polizze/controlador-tda1085c-agujereadora/Hardware/BOM_KiCad.csv

Refs | Value | Footprint | Qty | DNP | Parameters_and_Notes
C3 | 100nF | Capacitor_THT:C_Disc_D5.0mm_W2.5mm_P5.00mm | 1 |  | Filtro inmunidad ruido Pin 3 (I_LIM)
C4 | 470nF | Capacitor_THT:C_Rect_L7.2mm_W3.5mm_P5.00mm_FKS2_FKP2_MKS2_MKP2 | 1 |  | Integrador conversor F/V Pin 4 (5.14V @ 2500 RPM)
C5 | 100nF | Capacitor_THT:C_Disc_D5.0mm_W2.5mm_P5.00mm | 1 |  | Filtro consigna velocidad Pin 5 (V_SET)
C7 | 4.7uF / 50V | Capacitor_THT:CP_Radial_D6.3mm_P2.50mm | 1 |  | Rampa de aceleracion Soft-Start Pin 7
C11 | 1nF (o 470pF) | Capacitor_THT:C_Rect_L7.2mm_W3.5mm_P5.00mm_FKS2_FKP2_MKS2_MKP2 | 1 |  | Bomba de carga F/V Pin 11 (f_max = 166.6 Hz @ 2500 RPM)
C12 | 10nF (Prot. Picos) | Capacitor_THT:C_Disc_D5.0mm_W2.5mm_P5.00mm | 1 |  | Proteccion picos inductivos entrada Tacometro Pin 12 (f_c = 1.59 kHz)
C14 | 47nF (100Hz Saw) | Capacitor_THT:C_Rect_L7.2mm_W3.5mm_P5.00mm_FKS2_FKP2_MKS2_MKP2 | 1 |  | Generador rampa diente de sierra 100 Hz Pin 14
C16 | 1uF / 50V | Capacitor_THT:CP_Radial_D6.3mm_P2.50mm | 1 |  | Compensacion integral lazo PI Pin 16 (f_z = 3.39 Hz)
C17 | 47nF | Capacitor_THT:C_Disc_D5.0mm_W2.5mm_P5.00mm | 1 |  | Polo alta frecuencia lazo PI Pin 16 (f_p = 72.0 Hz)
C_DEC1 | 100nF | Capacitor_THT:C_Disc_D5.0mm_W2.5mm_P5.00mm | 1 |  | Desacoplo ceramico +VCC junto a Pines 8-9-10
C_SNUB1 | 100nF 400V X2 | Capacitor_THT:C_Rect_L18.0mm_W6.0mm_P15.00mm_FKS3_FKP3 | 1 |  | Polipropileno Clase X2 Red Snubber MT1-MT2
C_VCC1 | 220uF / 25V | Capacitor_THT:CP_Radial_D10.0mm_P5.00mm | 1 |  | Filtro principal +VCC (15.24V) para soportar picos de Gate de 88mA (admite 470uF/25V)
D1 | 1N4007 | Diode_THT:D_DO-41_SOD81_P10.16mm_Horizontal | 1 |  | Rectificador media onda fuente sin transformador
J1 | AC_220V_&_MOTOR_OUT | TerminalBlock_Phoenix:TerminalBlock_Phoenix_MKDS-3-4-5.08_1x04_P5.08mm_Horizontal | 1 |  | 1:L1_MT1 | 2:MT2->Motor Pin 6 (Azul Rotor) | 3:L2->Motor Pin 5 (Negro Estator) | 4:L2_AC_HOT
J2 | POT_PANEL_10k | Connector_PinHeader_2.54mm:PinHeader_1x03_P2.54mm_Vertical | 1 |  | Conector potenciometro lineal 10k de panel (400 - 2500 RPM)
J3 | TACHO_P3_P4 (73.0R 8P) | TerminalBlock_Phoenix:TerminalBlock_Phoenix_MKDS-1,5-2-5.08_1x02_P5.08mm_Horizontal | 1 |  | Entrada Tacometro Motor Pines 3 y 4 Rojos (R_tacho = 73.0 Ohm, 8 polos, 166.6 Hz @ 2500 RPM)
Q1 | BTB12-600BW (NO AISLADO) | TDA1085C_Custom:BTB12-600BW_Heatsink_40x20x80mm_LIVE_TAB | 1 |  | Triac Snubberless I_GT=50mA con Disipador 40x20x80mm - PELIGRO: ALETA VIVA EN MT2 (AISLAR CHASIS)
R1 | 820k 1/2W | Resistor_THT:R_Axial_DIN0411_L9.9mm_D3.6mm_P12.70mm_Horizontal | 1 |  | Sincronismo de corriente Triac (MT2 a Pin 1)
R2 | 820k 1/2W | Resistor_THT:R_Axial_DIN0411_L9.9mm_D3.6mm_P12.70mm_Horizontal | 1 |  | Sincronismo de tension AC (L2_AC_HOT a Pin 2)
R3 | 10k | Resistor_THT:R_Axial_DIN0207_L6.3mm_D2.5mm_P10.16mm_Horizontal | 1 |  | Referencia Pin 3 (I_LIM) a GND_CHIP
R4 | 270k | Resistor_THT:R_Axial_DIN0207_L6.3mm_D2.5mm_P10.16mm_Horizontal | 1 |  | Resistencia ganancia conversor F/V Pin 4 (270k con C11=1nF / 330k con C11=470pF)
R11 | 470k | Resistor_THT:R_Axial_DIN0207_L6.3mm_D2.5mm_P10.16mm_Horizontal | 1 |  | Polarizacion bomba de carga Pin 11 hacia +VCC (Pin 9)
R12 | 10k | Resistor_THT:R_Axial_DIN0207_L6.3mm_D2.5mm_P10.16mm_Horizontal | 1 |  | Limitadora de corriente entrada Tacometro Pin 12 (I_pk = 0.84 mA)
R15 | 270k | Resistor_THT:R_Axial_DIN0207_L6.3mm_D2.5mm_P10.16mm_Horizontal | 1 |  | Programacion corriente de rampa Pin 15 hacia +VCC (Pin 9)
R16 | 47k | Resistor_THT:R_Axial_DIN0207_L6.3mm_D2.5mm_P10.16mm_Horizontal | 1 |  | Ganancia proporcional lazo PI Pin 16 (Kp = 16 V/V)
RV1 | 50k Multivuelta | Potentiometer_THT:Potentiometer_Bourns_3296W_Vertical | 1 |  | Preset Bourns 3296W en serie con J2 para calibrar tope de 2500 RPM (ajuste ~24.1k)
R_DROP1 | 4.7k 3W (Elevar 5mm) | TDA1085C_Custom:R_Axial_3W_Elevated_Pad2.5mm_Drill1.2mm | 1 |  | Caida de tension etapa 1 (MOX 3W, Pad 2.5mm / Agujero 1.2mm, montar a 5mm del PCB)
R_DROP2 | 4.7k 3W (Elevar 5mm) | TDA1085C_Custom:R_Axial_3W_Elevated_Pad2.5mm_Drill1.2mm | 1 |  | Caida de tension etapa 2 (MOX 3W, Pad 2.5mm / Agujero 1.2mm, montar a 5mm del PCB)
R_GATE1 | 150R 1W | Resistor_THT:R_Axial_DIN0411_L9.9mm_D3.6mm_P12.70mm_Horizontal | 1 |  | Resistencia disparo Gate Pin 13 a Gate (I_G_pk = 88mA > 50mA I_GT)
R_MIN1 | 2.2k (Piso 400 RPM) | Resistor_THT:R_Axial_DIN0207_L6.3mm_D2.5mm_P10.16mm_Horizontal | 1 |  | Fija piso de 400 RPM (0.92V en Pin 5) al 0% del potenciometro
R_SNUB1 | 100R 1W | Resistor_THT:R_Axial_DIN0411_L9.9mm_D3.6mm_P12.70mm_Horizontal | 1 |  | Resistencia Red Snubber RC en serie con C_SNUB1
U1 | TDA1085C | Package_DIP:DIP-16_W7.62mm_Socket_LongPads | 1 |  | Controlador Universal Lazo Cerrado PI (Pin 8 GND_CHIP en Star Ground unico desde MT1)
M1 | Motor Universal C.E.SET. MCA 52/64-148/ALL7 | Externo_Bornera_7_Pines | 1 |  | R_estator(P1-P5)=2.1R + R_rotor(P2-P6)=6.5R -> R_tot=8.6R, L=25-30mH | Puente Serie P1(Gris osc)-P2(Violeta) | Tacho(P3-P4)=73.0R 8 Polos
FL1 | Filtro EMI FLCR47050 (250V 16A) | Externo_Chasis | 1 |  | Filtro EMI de linea previo a J1 + Fusible 4A
