polizze/controlador-tda1085c-agujereadora/Hardware/Fabrication/Esquematico_TDA1085C.pdf

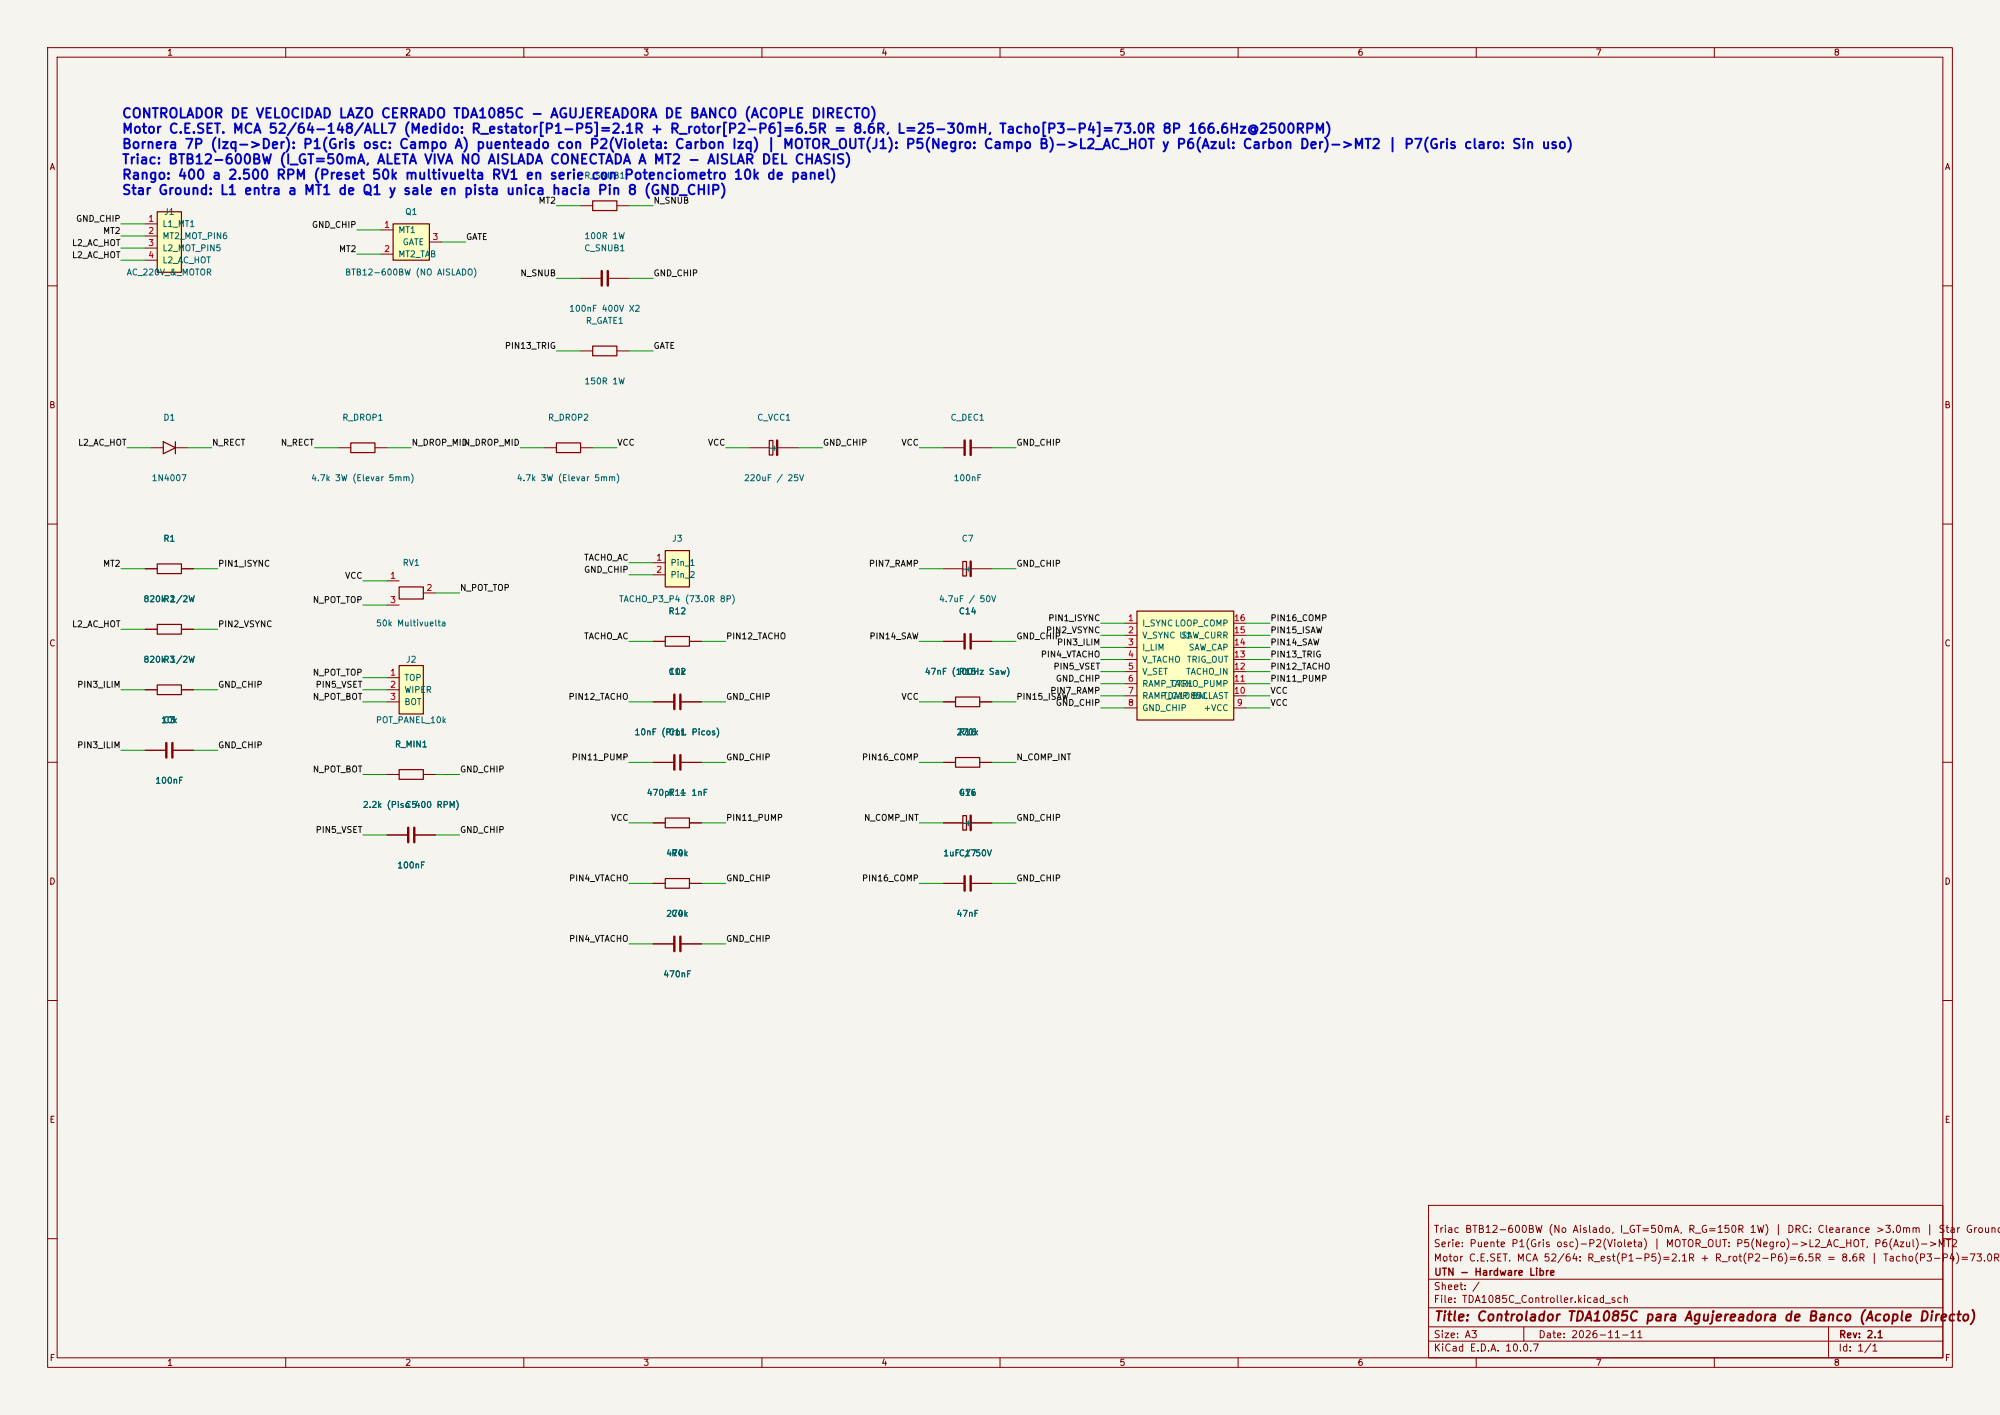
[picture p5: page 1]

GND_CHIP CONTROLADOR DE VELOCIDAD LAZO CERRADO TDA1085C - AGUJEREADORA DE BANCO (ACOPLE DIRECTO)
Motor C.E.SET. MCA 52/64-148/ALL7 (Medido: R_estator[P1-P5]=2.1R + R_rotor[P2-P6]=6.5R = 8.6R, L=25-30mH, Tacho[P3-P4]=73.0R 8P 166.6Hz@2500RPM)
Bornera 7P (Izq->Der): P1(Gris osc: Campo A) puenteado con P2(Violeta: Carbon Izq) | MOTOR_OUT(J1): P5(Negro: Campo B)->L2_AC_HOT y P6(Azul: Carbon Der)->MT2 | P7(Gris claro: Sin uso)
Triac: BTB12-600BW (I_GT=50mA, ALETA VIVA NO AISLADA CONECTADA A MT2 - AISLAR DEL CHASIS)
Rango: 400 a 2.500 RPM (Preset 50k multivuelta RV1 en serie con Potenciometro 10k de panel)
Star Ground: L1 entra a MT1 de Q1 y sale en pista unica hacia Pin 8 (GND_CHIP)

Triac BTB12-600BW (No Aislado, I_GT=50mA, R_G=150R 1W) | DRC: Clearance >3.0mm | Star Ground MT1
Serie: Puente P1(Gris osc)-P2(Violeta) | MOTOR_OUT: P5(Negro)->L2_AC_HOT, P6(Azul)->MT2
Motor C.E.SET. MCA 52/64: R_est(P1-P5)=2.1R + R_rot(P2-P6)=6.5R = 8.6R | Tacho(P3-P4)=73.0R 8P
UTN - Hardware Libre
Sheet: /
File: TDA1085C_Controller.kicad_sch
Title: Controlador TDA1085C para Agujereadora de Banco (Acople Directo)

Size: A3 | Rev: 2.1 | F Date: 2026-11-11
KiCad E.D.A. 10.0.7 | Id: 1/1
