polizze/controlador-tda1085c-agujereadora/Hardware/Fabrication/PCB_TDA1085C_Preview.pdf

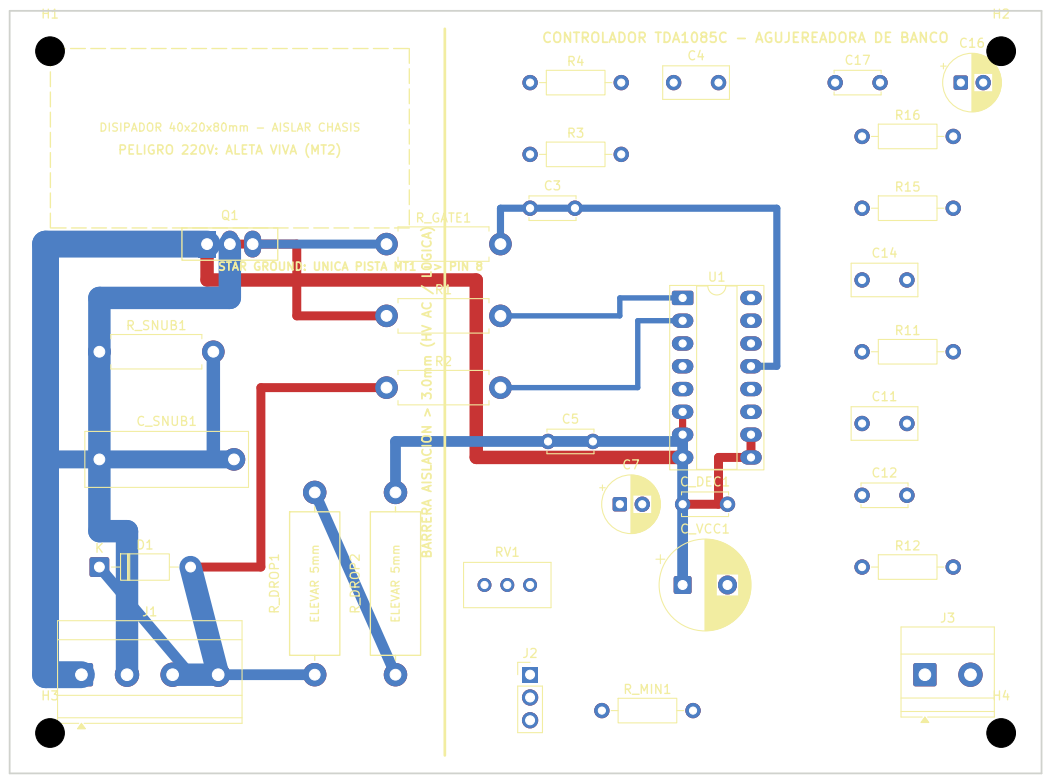
[picture p6: page 1]
