polizze/controlador-tda1085c-agujereadora/Simulations/etapa1b_conversor_fv_tacho.asc

B_MIRROR4_400: bi; I=if(V(PIN12_400)>0.1, 10.2*(13.9-V(PIN11_400))/10k, 0)
B_MIRROR4_2500: bi; I=if(V(PIN12_2500)>0.1, 10.2*(13.9-V(PIN11_2500))/10k, 0)
B_MIRROR4_ORIG: bi; I=if(V(PIN12_2500)>0.1, 10.2*(13.9-V(PIN11_2500))/10k, 0)
B_PUMP11_400: bi; I=if(V(PIN12_400)>0.1, (13.9-V(PIN11_400))/10k, (3.11-V(PIN11_400))/95.6k)
B_PUMP11_2500: bi; I=if(V(PIN12_2500)>0.1, (13.9-V(PIN11_2500))/10k, (3.11-V(PIN11_2500))/95.6k)
C4_OPT_400: cap; 470n
C4_OPT_2500: cap; 470n
C4_ORIG: cap; 470n
C11_400: cap; 1n
C11_2500: cap; 1n
C12_400: cap; 10n
C12_2500: cap; 10n
D_CLAMP12_1: diode; DCLAMP
D_CLAMP12_2: diode; DCLAMP
R4_OPT_400: res; 330k
R4_OPT_2500: res; 330k
R4_ORIG_68K: res; 68k
R12_400: res; 10k
R12_2500: res; 10k
R_BOB1: res; 73.0
R_BOB2: res; 73.0
R_DC11_1: res; 100Meg
R_DC11_2: res; 100Meg
V_TACHO_400RPM: voltage; SINE(0 1.414 26.67)
V_TACHO_2500RPM: voltage; SINE(0 8.84 166.6)
Named nets: 0, V_TACHO_RAW_2500, N_TC_2500, PIN12_2500, V_TACHO_RAW_400, N_TC_400, PIN12_400, PIN11_2500, PIN4_2500_OPT, PIN11_400, PIN4_400_OPT, PIN4_2500_68K_ORIG
.tran 0 1.2 0.8 20u
.model DCLAMP D(Is=10n Rs=2 N=1.2)
.meas TRAN Vpin12_2500_max MAX V(PIN12_2500)
.meas TRAN Vpin12_400_max MAX V(PIN12_400)
.meas TRAN Vpin11_2500_max MAX V(PIN11_2500)
.meas TRAN Vpin11_2500_min MIN V(PIN11_2500)
.meas TRAN Vpin4_2500_opt_avg AVG V(PIN4_2500_OPT)
.meas TRAN Vpin4_2500_opt_pp PP V(PIN4_2500_OPT)
.meas TRAN Vpin4_400_opt_avg AVG V(PIN4_400_OPT)
.meas TRAN Vpin4_400_opt_pp PP V(PIN4_400_OPT)
.meas TRAN Vpin4_2500_orig68k_avg AVG V(PIN4_2500_68K_ORIG)
RAMA 1: TACO A 2500 RPM (8 Polos -> f = 166.67 Hz, Vtacho = 8.84 Vpk) CON ESCALADO OPTIMIZADO (C11=1nF, R4=330k)
RAMA 2: TACO A 400 RPM (8 Polos -> f = 26.67 Hz, Vtacho = 1.41 Vpk) CON ESCALADO OPTIMIZADO (C11=1nF, R4=330k)
RAMA 3 (COMPARACION): SALIDA PIN 4 A 2500 RPM CON R4=68k ORIGINAL (Da solo ~1.25V en vez de 6V!)
