polizze/controlador-tda1085c-agujereadora/Simulations/etapa1c_triac_snubber_motor.asc

B_DVDT: bv; V=ddt(V(MT2))*1u
B_FEM_MOTOR: bv; V=38*tanh(I(L_MOTOR)/0.4)
B_SAW14: bi; I=if(abs(V(L2_AC_HOT))<25, (12.3-V(PIN14_SAW))/50, if(V(PIN14_SAW)>0.2, -55u, 0))
B_SW_NEG: bi; I=((0.5+0.5*tanh((V(GATE_LAT_N)-0.5)*30))/0.03 + 1u)*(V(MT2)-V(N_SCR_N))
B_SW_POS: bi; I=((0.5+0.5*tanh((V(GATE_LAT_P)-0.5)*30))/0.03 + 1u)*(V(MT2)-V(N_SCR_P))
C14_SAW: cap; 47n
C_EMI_X2: cap; 470n
C_SNUB: cap; 100n
D_SCR_NEG: diode; DSCR
D_SCR_POS: diode; DSCR
L_EMI: ind; 1m Rser=0.08
L_MOTOR: ind; 28m
R_DC14: res; 100Meg
R_DUMMY_DVDT: res; 1k
R_GATE: res; 150
R_GK_TRIAC: res; 18
R_MOTOR: res; 8.6
R_SNUB: res; 100
V_AC_220V: voltage; SINE(0 311.13 50)
V_PIN13_PULSE: voltage; PULSE(0 13.8 7.33m 1u 1u 80u 10m)
Named nets: 0, MAINS_RAW, L2_AC_HOT, N_RL_MOTOR, N_FEM_MOTOR, MT2, N_SCR_P, N_SCR_N, N_SNUB, PIN13_TRIG, GATE_NODE, PIN14_SAW, DVDT_SENSE
.tran 0 0.12 0.04 1u
.model DSCR D(Is=10n Rs=0.025 N=1.5 Cjo=150p TT=2u)
V_LAT_P GATE_LAT_P 0 PULSE(0 1 7.33m 10u 10u 6.0m 20m)
V_LAT_N GATE_LAT_N 0 PULSE(0 1 17.33m 10u 10u 6.0m 20m)
.meas TRAN I_motor_rms RMS I(L_MOTOR)
.meas TRAN I_motor_pk MAX I(L_MOTOR)
.meas TRAN V_motor_rms RMS (V(L2_AC_HOT)-V(MT2))
.meas TRAN V_mt2_rms RMS V(MT2)
.meas TRAN P_motor_avg AVG (V(L2_AC_HOT)-V(MT2))*I(L_MOTOR)
.meas TRAN P_Triac_avg AVG V(MT2)*(I(B_SW_POS)+I(B_SW_NEG))
.meas TRAN P_Rsnub_avg AVG (V(MT2)-V(N_SNUB))*I(R_SNUB)
.meas TRAN I_snub_pk MAX abs(I(R_SNUB))
.meas TRAN dVdt_comm_off_V_us MAX abs(V(DVDT_SENSE)) FROM 0.050 TO 0.0525
.meas TRAN V_snub_peak_off MAX abs(V(MT2)) FROM 0.050 TO 0.0525
.meas TRAN t_extinction WHEN I(L_MOTOR)=0 FALL=1 TD=0.048
.meas TRAN I_gate_pk MAX -I(R_GATE)
.meas TRAN P_Rgate_avg AVG (V(PIN13_TRIG)-V(GATE_NODE))*-I(R_GATE)
.meas TRAN Vsaw14_max MAX V(PIN14_SAW)
.meas TRAN Vsaw14_min MIN V(PIN14_SAW)
ETAPA 1C: RED 220V 50Hz + FILTRO EMI (FLCR47050) + MOTOR UNIVERSAL SERIE (R=5.2R, L=22mH + FEM) + TRIAC BTA16-600BW + SNUBBER (100R + 100nF)
