polizze/controlador-tda1085c-agujereadora/Simulations/etapa2_lazo_pi_conversor_fv.asc

B_GM_PI_PIN16: bi; I=limit(340u*(V(PIN5_VSET) - V(V_RPM_CLOSED_LOOP)*5.142/2.5), -200u, 200u)
B_MIRROR_PIN4: bi; I=if(V(PIN12_TACHO)>0.1, 10.2*(13.9-V(PIN11_PUMP))/10k, 0)
B_PLANT_TORQUE: bi; I=0.85*limit(V(PIN16_COMP), 0, 12) - I(I_DRILL_LOAD)
B_PUMP_PIN11: bi; I=if(V(PIN12_TACHO)>0.1, (13.9-V(PIN11_PUMP))/10k, (3.11-V(PIN11_PUMP))/95.6k)
C4: cap; 470n
C5: cap; 100n
C11: cap; 1n
C12_PROT: cap; 10n
C16_KI: cap; 1u
C17_HF: cap; 47n
C_INERTIA_MECH: cap; 60m
D_CLAMP12: diode; DCLAMP
R4: res; 270k
R12: res; 10k
R16_KP: res; 47k
R_CLAMP16: res; 10Meg
R_DAMP_MECH: res; 1
R_LEAK11: res; 100Meg
R_MIN_400RPM: res; 2.2k
R_TACHO_MEDIDA: res; 73.0
RV1_PRESET_50K: res; 24.1k
RV_PANEL_10K: res; 10k
V_TACHO_8POLOS: voltage; SINE(0 8.84 166.6)
V_VCC_PIN9: voltage; 15.24
Named nets: 0, TACHO_COIL_RAW, TACHO_P3_P4, PIN12_TACHO, PIN11_PUMP, PIN4_VTACHO, VCC_15V24, PIN5_VSET, N_POT_BOT, PIN16_COMP, N_PI_INT, V_RPM_CLOSED_LOOP
.tran 0 1.4 0.2 50u
.model DCLAMP D(Is=10n Rs=2 N=1.2)
.ic V(PIN16_COMP)=2.94 V(N_PI_INT)=2.94 V(V_RPM_CLOSED_LOOP)=2.50
I_DRILL_LOAD V_RPM_CLOSED_LOOP 0 PULSE(0 0.65 0.60 5m 5m 0.50 2.0)
.meas TRAN Vpin12_pk MAX V(PIN12_TACHO) FROM 0.8 TO 1.2
.meas TRAN I_tacho_pk_mA MAX I(R12)*1000 FROM 0.8 TO 1.2
.meas TRAN Vpin4_2500rpm_avg AVG V(PIN4_VTACHO) FROM 0.8 TO 1.2
.meas TRAN Vpin4_2500rpm_pp PP V(PIN4_VTACHO) FROM 0.8 TO 1.2
.meas TRAN Vpin5_set_max AVG V(PIN5_VSET) FROM 0.8 TO 1.2
.meas TRAN Vpin5_set_min AVG V(N_POT_BOT) FROM 0.8 TO 1.2
.meas TRAN Vpin16_no_load AVG V(PIN16_COMP) FROM 0.45 TO 0.58
.meas TRAN Vpin16_under_load AVG V(PIN16_COMP) FROM 0.90 TO 1.08
.meas TRAN RPM_steady_before AVG V(V_RPM_CLOSED_LOOP)*1000 FROM 0.45 TO 0.58
.meas TRAN RPM_dip_min MIN V(V_RPM_CLOSED_LOOP)*1000 FROM 0.60 TO 0.80
.meas TRAN RPM_steady_recovered AVG V(V_RPM_CLOSED_LOOP)*1000 FROM 0.95 TO 1.08
BLOQUE A: CONVERSOR F-V (Pin 12, 11 y 4) CON PARAMETROS MEDIDOS: R_tacho = 73.0 Ohm, 8 Polos, f(2500 RPM) = 166.6 Hz, C12 = 10nF, C11 = 1nF, R4 = 270k
BLOQUE B: CONSIGNA (Pin 5: Preset 50k + Pot 10k + Piso 2.2k) Y LAZO CERRADO PI (Pin 16: gm=340uA/V, R16=47k + C16=1uF || C17=47nF) ANTE ESCALON DE CARGA EN t=0.6s
