polizze/controlador-tda1085c-agujereadora/Simulations/tda1085c_controlador_completo_btb12.asc

B_BTB12_NEG: bi; I=((0.5+0.5*tanh((V(GATE_LAT_N)-0.5)*30))/0.03 + 1u)*(V(PIN6_ROTOR_AZUL_MT2)-V(N_SCR_N))
B_BTB12_POS: bi; I=((0.5+0.5*tanh((V(GATE_LAT_P)-0.5)*30))/0.03 + 1u)*(V(PIN6_ROTOR_AZUL_MT2)-V(N_SCR_P))
B_FEM_ROTOR: bv; V=38*tanh(I(L_ROTOR_P2_P6)/0.4)
B_MIRROR4_1N: bi; I=if(V(PIN12_TACHO)>0.1, 10.2*(13.9-V(PIN11_1N))/10k, 0)
B_MIRROR4_470P: bi; I=if(V(PIN12_TACHO)>0.1, 10.2*(13.9-V(PIN11_470P))/10k, 0)
B_PUMP_1N: bi; I=if(V(PIN12_TACHO)>0.1, (13.9-V(PIN11_1N))/10k, (3.11-V(PIN11_1N))/95.6k)
B_PUMP_470P: bi; I=if(V(PIN12_TACHO)>0.1, (13.9-V(PIN11_470P))/10k, (3.11-V(PIN11_470P))/95.6k)
C4_A: cap; 470n
C4_B: cap; 470n
C11_A_470P: cap; 470p
C11_B_1N: cap; 1n
C_DEC_VCC: cap; 100n
C_EMI_X2: cap; 470n
C_SNUB_100N_X2: cap; 100n
C_TACHO_PROT_10N: cap; 10n
C_VCC: cap; 220u
D1: diode; D1N4007
D_BTB12_NEG: diode; DSCR
D_BTB12_POS: diode; DSCR
D_GK_BTB12: diode; D1N4007
D_PIN12_CLAMP: diode; DCLAMP
DZ_SHUNT_PIN10: zener; DZ15V6
L_EMI: ind; 1m Rser=0.08
L_ESTATOR_P5_P1: ind; 15m
L_ROTOR_P2_P6: ind; 13m
R4_A: res; 330k
R4_B: res; 270k
R12_LIMIT: res; 10k
R_DC11A: res; 100Meg
R_DC11B: res; 100Meg
R_DROP1: res; 4.7k
R_DROP2: res; 4.7k
R_ESTATOR_P5_P1: res; 2.1
R_GATE_150R: res; 150
R_GK_BTB12: res; 15
R_ICC_TDA1085C: res; 2.5k
R_MIN_400RPM: res; 2.2k
R_ROTOR_P2_P6: res; 6.5
R_SNUB_100R_1W: res; 100
R_TACHO_COIL: res; 73.0
RV1_PRESET_50K: res; 24.1k
RV2_POT_10K: res; 10k
V_AC_220V: voltage; SINE(0 311.13 50)
V_PIN13_TRIG: voltage; PULSE(0 13.8 7.33m 1u 1u 80u 10m)
V_TACHO_GEN: voltage; SINE(0 8.84 166.6)
Named nets: 0, L2_AC_HOT, N_RECT, N_DROP_MID, VCC_PIN9, N_POT_TOP, PIN5_VSET_MAX, PIN13_TRIG, GATE_BTB12, V_TACHO_2500, N_TACHO_P3_P4, PIN12_TACHO, PIN11_470P, PIN4_470P_2500, PIN11_1N, PIN4_1N_2500, PIN5_ESTATOR_NEGRO, N_ESTATOR_INT, PUENTE_PIN1_GRIS_PIN2_VIOLETA, N_ROTOR_INT, N_ROTOR_FEM, PIN6_ROTOR_AZUL_MT2, N_SCR_P, N_SCR_N, N_SNUB
.tran 0 1.2 0.8 20u
.model D1N4007 D(Is=7.027n Rs=0.03415 N=1.808 BV=1000 IBV=5u Cjo=18.5p TT=5.7u)
.model DZ15V6 D(Is=1n Rs=8 BV=15.3 IBV=5m N=1.5)
.model DCLAMP D(Is=10n Rs=2 N=1.2)
.model DSCR D(Is=10n Rs=0.025 N=1.5 Cjo=150p TT=2u)
I_PULSE_LOAD 0 VCC_PIN9 PULSE(0 82m 7.33m 1u 1u 80u 10m)
V_LAT_P GATE_LAT_P 0 PULSE(0 1 7.33m 10u 10u 6.0m 20m)
V_LAT_N GATE_LAT_N 0 PULSE(0 1 17.33m 10u 10u 6.0m 20m)
.meas TRAN Vcc_avg AVG V(VCC_PIN9)
.meas TRAN Vcc_pp PP V(VCC_PIN9)
.meas TRAN P_Rdrop1_W AVG (V(N_RECT)-V(N_DROP_MID))*I(D1)
.meas TRAN I_gate_pk_mA MAX -I(R_GATE_150R)*1000
.meas TRAN P_Rgate_mW AVG (V(PIN13_TRIG)-V(GATE_BTB12))*-I(R_GATE_150R)*1000
.meas TRAN Vset_max_100pct AVG V(N_POT_TOP)
.meas TRAN Vset_min_0pct AVG V(PIN5_VSET_MAX)
.meas TRAN Vpin4_470p_2500rpm AVG V(PIN4_470P_2500)
.meas TRAN Vpin4_1n_2500rpm AVG V(PIN4_1N_2500)
.meas TRAN I_motor_rms RMS I(L_ROTOR_P2_P6)
.meas TRAN P_motor_W AVG (V(PIN5_ESTATOR_NEGRO)-V(PIN6_ROTOR_AZUL_MT2))*I(L_ROTOR_P2_P6)
.meas TRAN P_BTB12_W AVG V(PIN6_ROTOR_AZUL_MT2)*(I(B_BTB12_POS)+I(B_BTB12_NEG))
.meas TRAN P_Snubber_W AVG (V(PIN6_ROTOR_AZUL_MT2)-V(N_SNUB))*I(R_SNUB_100R_1W)
BLOQUE 1: FUENTE (2x 4.7k 3W + C_VCC=220uF/25V) + PRESET 50k EN SERIE CON POT 10k + DISPARO GATE R_G=150R (1W) -> BTB12-600BW (I_GT=50mA)
BLOQUE 2: TACOMETRO MEDIDO (Pines 3-4 Rojos: R_tacho=73.0R, 8 Polos, 166.6Hz @ 2500 RPM) + FILTRO 10k/10nF + BOMBA DE CARGA C11=470pF vs 1nF
BLOQUE 3: MOTOR C.E.SET. MCA 52/64 SERIE: Pin 5 (Negro) -> Estator (2.1R+15mH) -> Puente Pin 1 (Gris) a Pin 2 (Violeta) -> Rotor (6.5R+13mH+FEM) -> Pin 6 (Azul, MT2)
