polizze/controlador-tda1085c-agujereadora/Simulations/etapa1a_fuente_tda1085c.asc

C_DEC1: cap; 100n
C_DEC2: cap; 100n
C_DEC3: cap; 100n
C_PRE3: cap; 100u
C_VCC1: cap; 220u
C_VCC2: cap; 220u
C_VCC3: cap; 220u
D1: diode; D1N4007
D2: diode; D1N4007
D3: diode; D1N4007
DZ1: zener; DZ15V6
DZ2: zener; DZ15V6
DZ3: zener; DZ15V6
I_GATE1: current; PULSE(0 85m 2m 1u 1u 55u 10m)
I_GATE2: current; PULSE(0 85m 2m 1u 1u 55u 10m)
I_GATE3: current; PULSE(0 85m 2m 1u 1u 55u 10m)
R_DROP1A: res; 4.7k
R_DROP1B: res; 4.7k
R_DROP2A: res; 4.7k
R_DROP2B: res; 4.7k
R_DROP3A: res; 2.7k
R_DROP3B: res; 2.7k
R_FILT3: res; 270
R_LOAD_15MA: res; 1.02k
R_LOAD_NOM: res; 2.35k
R_LOAD_OPT: res; 1.02k
V_MAINS: voltage; SINE(0 311.13 50)
Named nets: 0, L2_AC_HOT, N_RECT_1, N_MID_1, VCC_9K4_15MA, N_RECT_2, N_MID_2, VCC_9K4_NOM, N_RECT_3, N_MID_3, V_PREFILT, VCC_OPT_5K4
.tran 0 1.5 1.1 50u
.model D1N4007 D(Is=7.027n Rs=0.03415 N=1.808 BV=1000 IBV=5u Cjo=18.5p TT=5.7u)
.model DZ15V6 D(Is=1n Rs=8 BV=15.3 IBV=5m N=1.5)
.meas TRAN Vcc1_avg AVG V(VCC_9K4_15MA)
.meas TRAN Vcc1_pp PP V(VCC_9K4_15MA)
.meas TRAN Iz1_avg AVG -I(DZ1)
.meas TRAN Iz1_min MIN -I(DZ1)
.meas TRAN P_Rdrop1A AVG (V(N_RECT_1)-V(N_MID_1))*I(D1)
.meas TRAN Vcc2_avg AVG V(VCC_9K4_NOM)
.meas TRAN Vcc2_pp PP V(VCC_9K4_NOM)
.meas TRAN Iz2_avg AVG -I(DZ2)
.meas TRAN Iz2_min MIN -I(DZ2)
.meas TRAN P_Rdrop2A AVG (V(N_RECT_2)-V(N_MID_2))*I(D2)
.meas TRAN Vcc3_avg AVG V(VCC_OPT_5K4)
.meas TRAN Vcc3_pp PP V(VCC_OPT_5K4)
.meas TRAN Iz3_avg AVG -I(DZ3)
.meas TRAN Iz3_min MIN -I(DZ3)
.meas TRAN P_Rdrop3A AVG (V(N_RECT_3)-V(N_MID_3))*I(D3)
CASO 1: 2x 4.7k (9.4k) con carga de estres (15mA @ 15.3V + Pulsos Gate) -> PIERDE REGULACION (~9.7V)
CASO 2: 2x 4.7k (9.4k) con consumo nominal TDA1085C (6.5mA + Pulsos Gate) -> REGULA OK (15.5V)
CASO 3: Diseno Optimizado Datasheet (2x 2.7k + Doble Filtro 100u/270R/220u) con 15mA + Gate -> REGULA CON MARGEN
