polizze/controlador-tda1085c-agujereadora/Hardware/TDA1085C_Controller/TDA1085C_Controller.kicad_pcb

## KiCad design Hardware/TDA1085C_Controller/TDA1085C_Controller.kicad_pcb (2026-11-11)

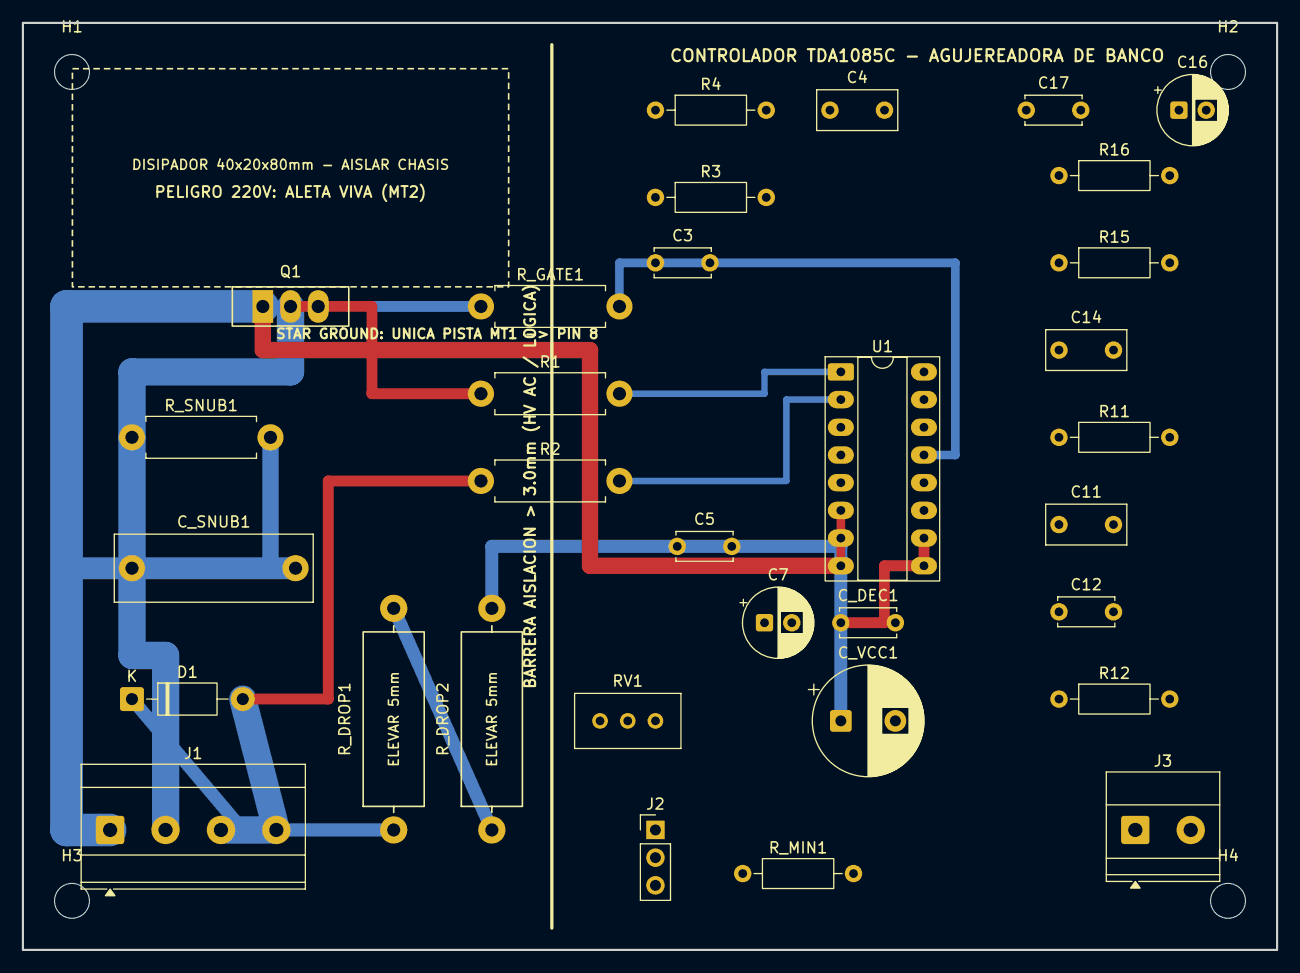
[picture p7: board TDA1085C_Controller.kicad_pcb from above]

Board: 2 copper layers, 115.0 x 85.0 mm, 36 parts (0 on the bottom side), 24 nets.

Parts:
C3, C5: 100nF; C_Disc_D5.0mm_W2.5mm_P5.00mm
C4: 470nF; C_Rect_L7.2mm_W3.5mm_P5.00mm_FKS2_FKP2_MKS2_MKP2
C7: 4.7uF/50V; CP_Radial_D6.3mm_P2.50mm
C11: 470pF-1nF; C_Rect_L7.2mm_W3.5mm_P5.00mm_FKS2_FKP2_MKS2_MKP2
C12: 10nF; C_Disc_D5.0mm_W2.5mm_P5.00mm
C14: 47nF; C_Rect_L7.2mm_W3.5mm_P5.00mm_FKS2_FKP2_MKS2_MKP2
C16: 1uF/50V; CP_Radial_D6.3mm_P2.50mm
C17: 47nF; C_Disc_D5.0mm_W2.5mm_P5.00mm
C_DEC1: 100nF; C_Disc_D5.0mm_W2.5mm_P5.00mm
C_SNUB1: 100nF 400V X2; C_Rect_L18.0mm_W6.0mm_P15.00mm_FKS3_FKP3
C_VCC1: 220uF/25V; CP_Radial_D10.0mm_P5.00mm
D1: 1N4007; D_DO-41_SOD81_P10.16mm_Horizontal
H1, H2, H3, H4: M3_Hole; MountingHole_3.2mm_M3
J1: AC_220V_MOTOR; TerminalBlock_Phoenix_MKDS-3-4-5.08_1x04_P5.08mm_Horizontal
J2: POT_10k; PinHeader_1x03_P2.54mm_Vertical
J3: TACHO_IN; TerminalBlock_Phoenix_MKDS-1,5-2-5.08_1x02_P5.08mm_Horizont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
Q1: BTB12-600BW; BTB12-600BW_Heatsink_40x20x80mm_LIVE_TAB
R1, R2: 820k 1/2W; R_Axial_DIN0411_L9.9mm_D3.6mm_P12.70mm_Horizontal
R3, R12: 10k; R_Axial_DIN0207_L6.3mm_D2.5mm_P10.16mm_Horizontal
R4, R15: 270k; R_Axial_DIN0207_L6.3mm_D2.5mm_P10.16mm_Horizontal
R11: 470k; R_Axial_DIN0207_L6.3mm_D2.5mm_P10.16mm_Horizontal
R16: 47k; R_Axial_DIN0207_L6.3mm_D2.5mm_P10.16mm_Horizontal
RV1: 50k_Multivuelta; Potentiometer_Bourns_3296W_Vertical
R_DROP1, R_DROP2: 4.7k 3W; R_Axial_3W_Elevated_Pad2.5mm_Drill1.2mm
R_GATE1: 150R 1W; R_Axial_DIN0411_L9.9mm_D3.6mm_P12.70mm_Horizontal
R_MIN1: 2.2k; R_Axial_DIN0207_L6.3mm_D2.5mm_P10.16mm_Horizontal
R_SNUB1: 100R 1W; R_Axial_DIN0411_L9.9mm_D3.6mm_P12.70mm_Horizontal
U1: TDA1085C; DIP-16_W7.62mm_Socket_LongPads

Connections:
GATE: Q1.3, R_GATE1.1
GND_CHIP: C3.2, C4.2, C5.2, C7.2, C11.2, C12.2, C14.2, C16.2, C17.2, C_DEC1.2, C_SNUB1.2, C_VCC1.2, J1.1, J3.2, Q1.1, R3.2, R4.2, R_MIN1.2, U1.6, U1.8
L2_AC_HOT: D1.2, J1.3, J1.4, R2.1
MT2: J1.2, Q1.2, R1.1, R_SNUB1.1
N_COMP_INT: C16.1, R16.2
N_DROP_MID: R_DROP1.2, R_DROP2.1
N_POT_BOT: J2.3, R_MIN1.1
N_POT_TOP: J2.1, RV1.2, RV1.3
N_RECT: D1.1, R_DROP1.1
N_SNUB: C_SNUB1.1, R_SNUB1.2
PIN1_ISYNC: R1.2, U1.1
PIN2_VSYNC: R2.2, U1.2
PIN3_ILIM: C3.1, R3.1, U1.3
PIN4_VTACHO: C4.1, R4.1, U1.4
PIN5_VSET: C5.1, J2.2, U1.5
PIN7_RAMP: C7.1, U1.7
PIN11_PUMP: C11.1, R11.2, U1.11
PIN12_TACHO: C12.1, R12.2, U1.12
PIN13_TRIG: R_GATE1.2, U1.13
PIN14_SAW: C14.1, U1.14
PIN15_ISAW: R15.2, U1.15
PIN16_COMP: C17.1, R16.1, U1.16
TACHO_AC: J3.1, R12.1
VCC: C_DEC1.1, C_VCC1.1, R11.1, R15.1, RV1.1, R_DROP2.2, U1.9, U1.10
