polizze/controlador-tda1085c-agujereadora/(commit log)

2026-11-11 Commit inicial: Estructura del proyecto TDA1085C y simulaciones
    [BOM_KiCad.csv, TDA1085C_Controller.kicad_pcb, TDA1085C_Controller.kicad_sch]
2026-11-11 Medición de parámetros y actualizacion simu
    [BOM_KiCad.csv, TDA1085C_Controller.kicad_pcb, TDA1085C_Controller.kicad_sch]
